gumulka/usb-hub/3D/USB_type_C_smd_12p.stp

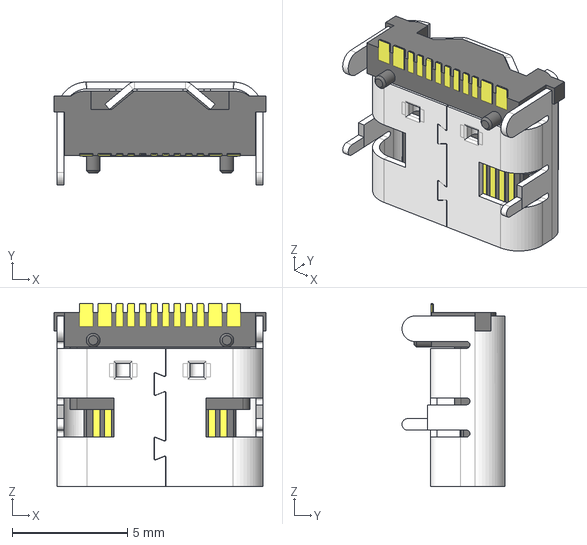
[picture p1: CAD file, 2024-03-02]
3D/USB_type_C_smd_12p.stp
9.20 x 4.47 x 7.95 mm
