gumulka/usb-hub/3D/694106301002 (rev1).stp

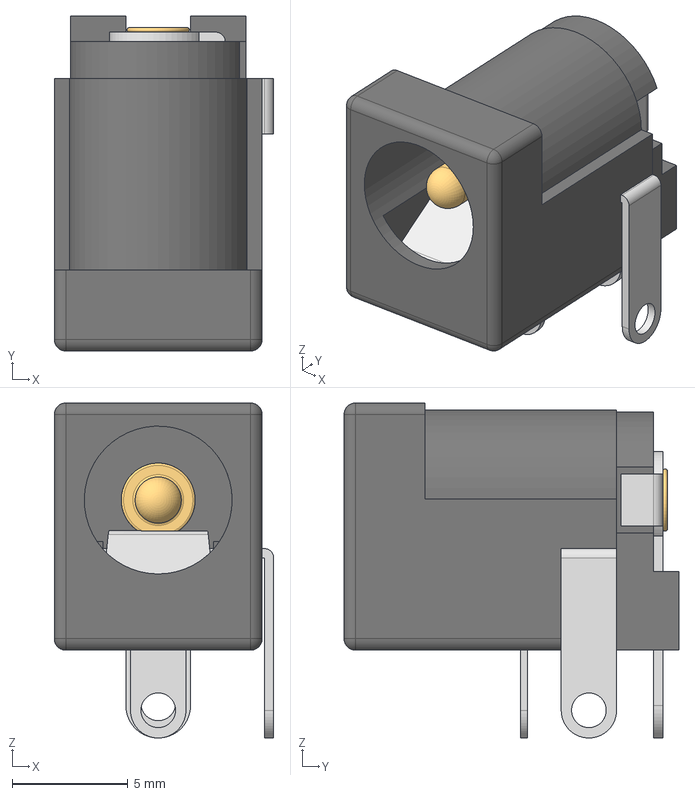
[picture p2: CAD file, 2024-03-02]
3D/694106301002 (rev1).stp
9.50 x 14.5 x 14.5 mm
6941xx301002
694106301002_PinContact
6941xx301002_Back
6941xx301002_PinContact2
6941xx301002_PinLame
6941xx301002_PinBis
