gumulka/usb-hub/usb-hub.kicad_pcb

## KiCad design usb-hub.kicad_pcb (2024-03-20)

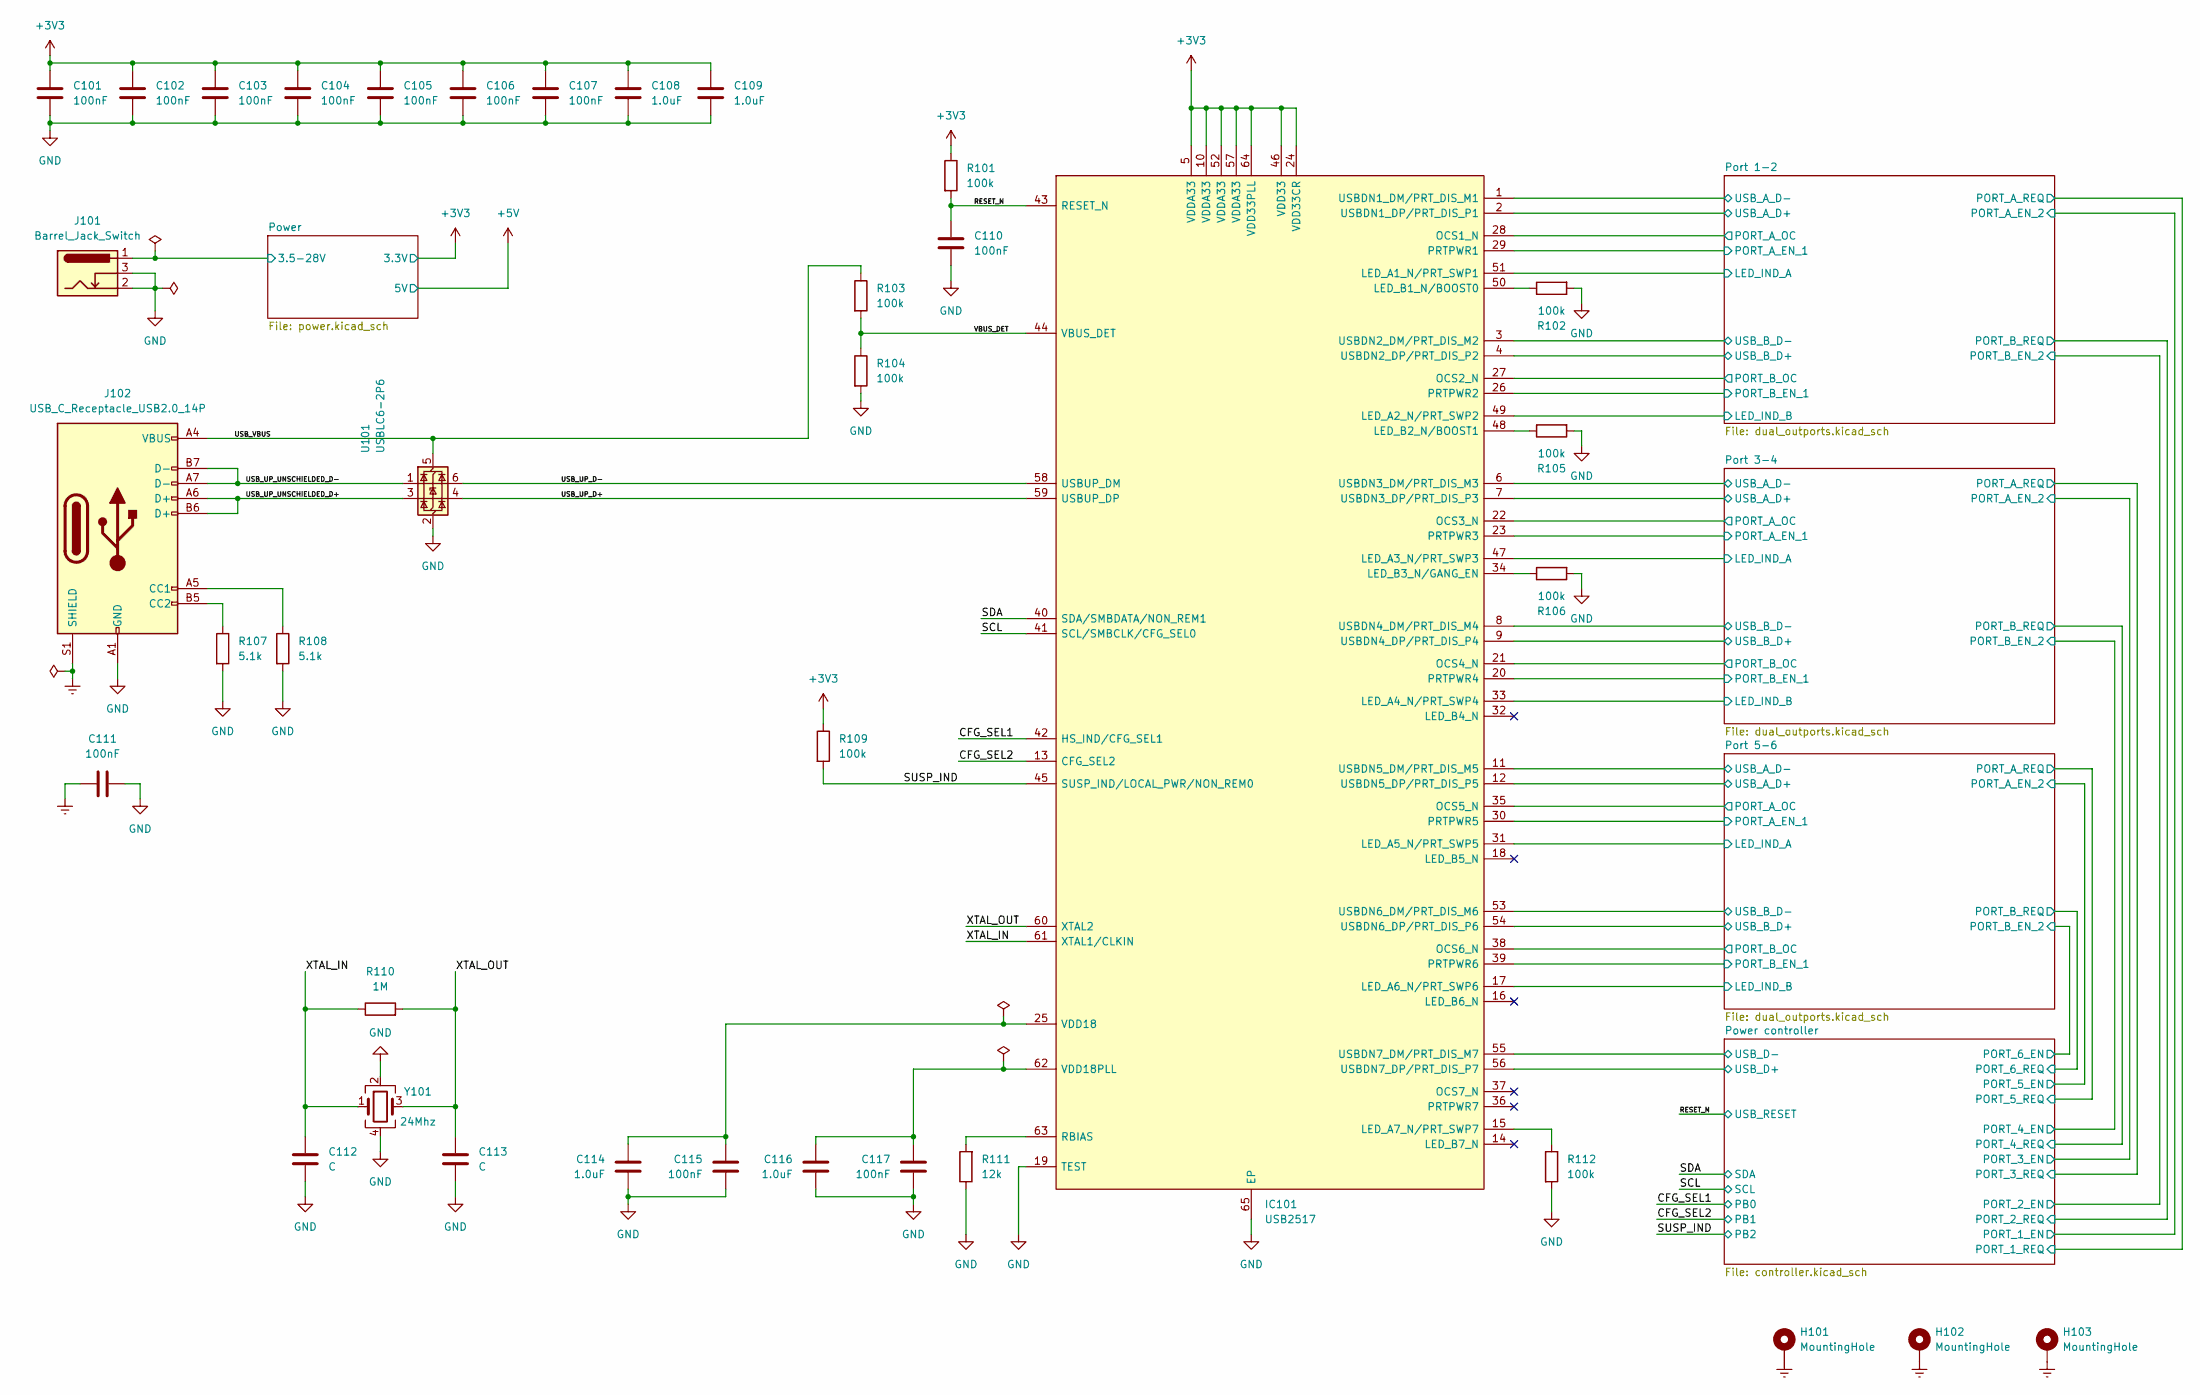
[picture p3: schematic usb-hub.kicad_sch, Switchable USB Hub]

Parts:
C101, C102, C103, C104, C105, C106, C107, C110, C111, C115, C117: 100nF; C_0402_1005Metric; LCSC# C307331
C108, C109, C114, C116: 1.0uF; C_0603_1608Metric; LCSC# C15849
C112, C113: C; C_0402_1005Metric
H101, H102, H103: MountingHole; MountingHole_3.2mm_M3_Pad_Via
IC101: USB2517; QFN-64-1EP_9x9mm_P0.5mm_EP4.7x4.7mm_ThermalVias; MPN USB2517; LCSC# C626668
J101: Barrel_Jack_Switch; BarrelJack_Wuerth_6941xx301002; MPN 694106301002
J102: USB_C_Receptacle_USB2.0_14P; USB_C_Receptacle_G-Switch_GT-USB-7010ASV; LCSC# C2988369
R101, R102, R103, R104, R105, R106, R109, R112: 100k; R_0402_1005Metric; MPN 100K; LCSC# C25741
R107, R108: 5.1k; R_0402_1005Metric; MPN 5,1K; LCSC# C25905
R110: 1M; R_0402_1005Metric; MPN 1M; LCSC# C26083
R111: 12k; R_0402_1005Metric; MPN 12K; LCSC# C25752
U101: USBLC6-2P6; SOT-666; MPN USBLC6-2P6; LCSC# C2827693
Y101: 24Mhz; Crystal_SMD_3225-4Pin_3.2x2.5mm; LCSC# C70590

Connections:
+3V3: C101.1, C102.1, C103.1, C104.1, C105.1, C106.1, C107.1, C108.1, C109.1, IC101.5 (VDDA33), IC101.10 (VDDA33), IC101.24 (VDD33CR), IC101.46 (VDD33), IC101.52 (VDDA33), IC101.57 (VDDA33), IC101.64 (VDD33PLL), R101.1, R109.1; also elsewhere on the board
/CFG_SEL1: IC101.42 (HS_IND/CFG_SEL1); also elsewhere on the board
/CFG_SEL2: IC101.13 (CFG_SEL2); also elsewhere on the board
/Port 1-2/LED_IND_A: IC101.51 (LED_A1_N/PRT_SWP1); also elsewhere on the board
/Port 1-2/LED_IND_B: IC101.49 (LED_A2_N/PRT_SWP2); also elsewhere on the board
/Port 1-2/PORT_A_EN_1: IC101.29 (PRTPWR1); also elsewhere on the board
/Port 1-2/PORT_A_OC: IC101.28 (OCS1_N); also elsewhere on the board
/Port 1-2/PORT_B_EN_1: IC101.26 (PRTPWR2); also elsewhere on the board
/Port 1-2/PORT_B_OC: IC101.27 (OCS2_N); also elsewhere on the board
/Port 1-2/USB_A_D+: IC101.2 (USBDN1_DP/PRT_DIS_P1); also elsewhere on the board
/Port 1-2/USB_A_D-: IC101.1 (USBDN1_DM/PRT_DIS_M1); also elsewhere on the board
/Port 1-2/USB_B_D+: IC101.4 (USBDN2_DP/PRT_DIS_P2); also elsewhere on the board
/Port 1-2/USB_B_D-: IC101.3 (USBDN2_DM/PRT_DIS_M2); also elsewhere on the board
/Port 3-4/LED_IND_A: IC101.47 (LED_A3_N/PRT_SWP3); also elsewhere on the board
/Port 3-4/LED_IND_B: IC101.33 (LED_A4_N/PRT_SWP4); also elsewhere on the board
/Port 3-4/PORT_A_EN_1: IC101.23 (PRTPWR3); also elsewhere on the board
/Port 3-4/PORT_A_OC: IC101.22 (OCS3_N); also elsewhere on the board
/Port 3-4/PORT_B_EN_1: IC101.20 (PRTPWR4); also elsewhere on the board
/Port 3-4/PORT_B_OC: IC101.21 (OCS4_N); also elsewhere on the board
/Port 3-4/USB_A_D+: IC101.7 (USBDN3_DP/PRT_DIS_P3); also elsewhere on the board
/Port 3-4/USB_A_D-: IC101.6 (USBDN3_DM/PRT_DIS_M3); also elsewhere on the board
/Port 3-4/USB_B_D+: IC101.9 (USBDN4_DP/PRT_DIS_P4); also elsewhere on the board
/Port 3-4/USB_B_D-: IC101.8 (USBDN4_DM/PRT_DIS_M4); also elsewhere on the board
/Port 5-6/LED_IND_A: IC101.31 (LED_A5_N/PRT_SWP5); also elsewhere on the board
/Port 5-6/LED_IND_B: IC101.17 (LED_A6_N/PRT_SWP6); also elsewhere on the board
/Port 5-6/PORT_A_EN_1: IC101.30 (PRTPWR5); also elsewhere on the board
/Port 5-6/PORT_A_OC: IC101.35 (OCS5_N); also elsewhere on the board
/Port 5-6/PORT_B_EN_1: IC101.39 (PRTPWR6); also elsewhere on the board
/Port 5-6/PORT_B_OC: IC101.38 (OCS6_N); also elsewhere on the board
/Port 5-6/USB_A_D+: IC101.12 (USBDN5_DP/PRT_DIS_P5); also elsewhere on the board
/Port 5-6/USB_A_D-: IC101.11 (USBDN5_DM/PRT_DIS_M5); also elsewhere on the board
/Port 5-6/USB_B_D+: IC101.54 (USBDN6_DP/PRT_DIS_P6); also elsewhere on the board
/Port 5-6/USB_B_D-: IC101.53 (USBDN6_DM/PRT_DIS_M6); also elsewhere on the board
/Power controller/USB_D+: IC101.56 (USBDN7_DP/PRT_DIS_P7); also elsewhere on the board
/Power controller/USB_D-: IC101.55 (USBDN7_DM/PRT_DIS_M7); also elsewhere on the board
/Power/3.5-28V: J101.1; also elsewhere on the board
/RESET_N: C110.1, IC101.43 (RESET_N), R101.2; also elsewhere on the board
/SCL: IC101.41 (SCL/SMBCLK/CFG_SEL0); also elsewhere on the board
/SDA: IC101.40 (SDA/SMBDATA/NON_REM1); also elsewhere on the board
/SUSP_IND: IC101.45 (SUSP_IND/LOCAL_PWR/NON_REM0), R109.2; also elsewhere on the board
/USB_UP_D+: IC101.59 (USBUP_DP), U101.4 (I/O2)
/USB_UP_D-: IC101.58 (USBUP_DM), U101.6 (I/O1)
/USB_UP_UNSCHIELDED_D+: J102.A6 (D+), J102.B6 (D+), U101.3 (I/O2)
/USB_UP_UNSCHIELDED_D-: J102.A7 (D-), J102.B7 (D-), U101.1 (I/O1)
/USB_VBUS: J102.A4 (VBUS), J102.A9 (VBUS), J102.B4 (VBUS), J102.B9 (VBUS), R103.1, U101.5 (VBUS)
/VBUS_DET: IC101.44 (VBUS_DET), R103.2, R104.1
/XTAL_IN: C112.1, IC101.61 (XTAL1/CLKIN), R110.1, Y101.1
/XTAL_OUT: C113.1, IC101.60 (XTAL2), R110.2, Y101.3
Earth: C111.2, H101.1, H102.1, H103.1, J102.S1 (SHIELD); also elsewhere on the board
GND: C101.2, C102.2, C103.2, C104.2, C105.2, C106.2, C107.2, C108.2, C109.2, C110.2, C111.1, C112.2, C113.2, C114.2, C115.2, C116.2, C117.2, IC101.19 (TEST), IC101.65 (EP), J101.2, J101.3, J102.A1 (GND), J102.A12 (GND), J102.B1 (GND), J102.B12 (GND), R102.2, R104.2, R105.2, R106.2, R107.2, R108.2, R111.1, R112.2, U101.2 (GND), Y101.2, Y101.4; also elsewhere on the board
unnamed: IC101.15 (LED_A7_N/PRT_SWP7), R112.1
unnamed: IC101.50 (LED_B1_N/BOOST0), R102.1
unnamed: IC101.48 (LED_B2_N/BOOST1), R105.1
unnamed: IC101.34 (LED_B3_N/GANG_EN), R106.1
unnamed: IC101.63 (RBIAS), R111.2
unnamed: C114.1, C115.1, IC101.25 (VDD18)
unnamed: C116.1, C117.1, IC101.62 (VDD18PLL)
unnamed: J102.A5 (CC1), R108.1
unnamed: J102.B5 (CC2), R107.1

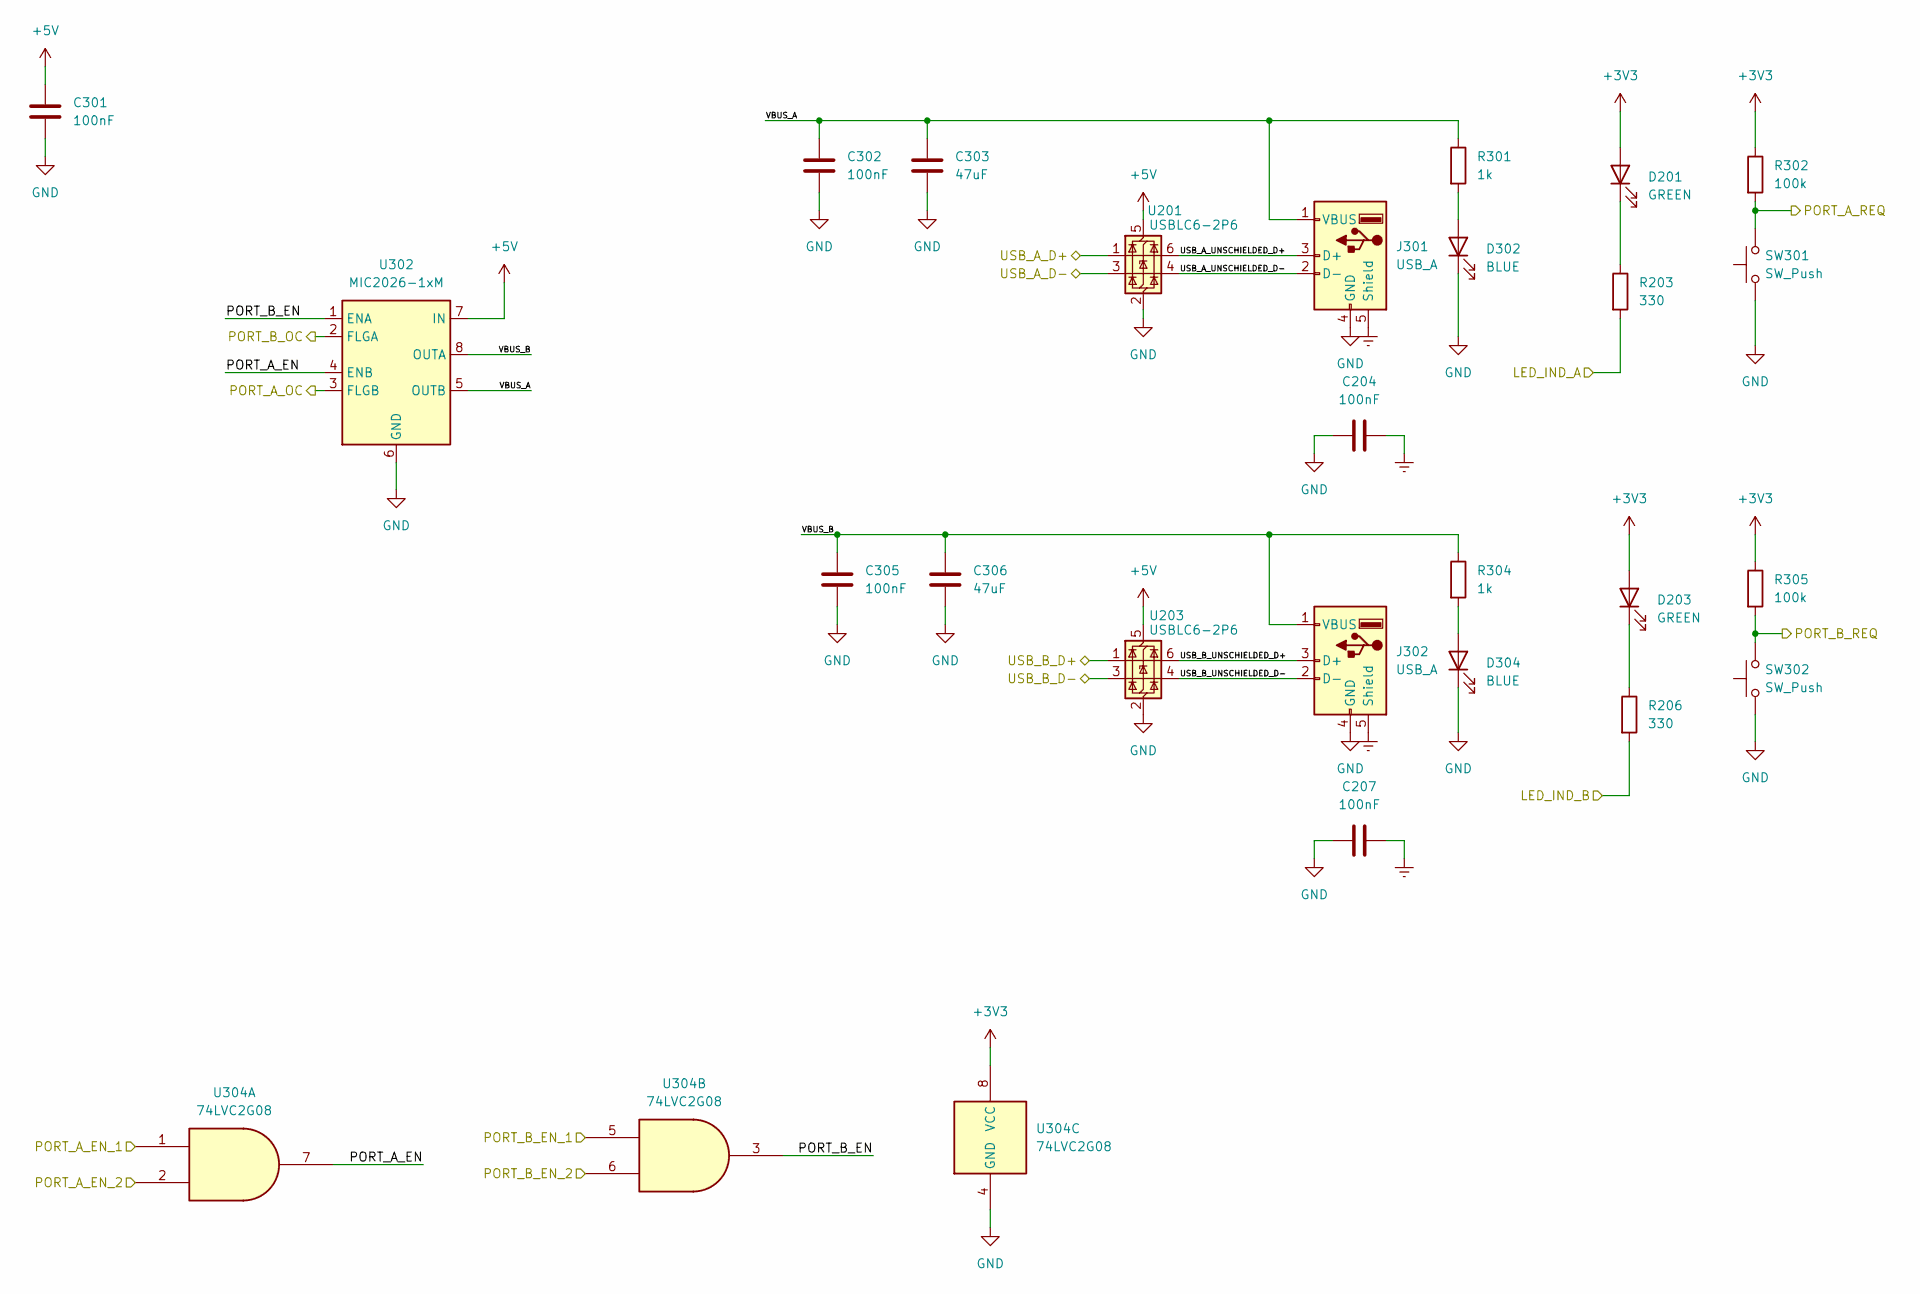
[picture p4: schematic dual_outports.kicad_sch, Switchable USB Hub]

Parts:
C204, C207, C301, C302, C305: 100nF; C_0402_1005Metric; LCSC# C307331
C303, C306: 47uF; C_0805_2012Metric; LCSC# C16780
D201, D203: GREEN; LED_0603_1608Metric; LCSC# C2986059
D302, D304: BLUE; LED_0603_1608Metric; LCSC# C72041
J301, J302: USB_A; UJ2-AV-W4-TH; MPN UJ2-AV-W4-TH
R203, R206: 330; R_0402_1005Metric; MPN 330R; LCSC# C25104
R301, R304: 1k; R_0402_1005Metric; MPN 1k; LCSC# C11702
R302, R305: 100k; R_0402_1005Metric; MPN 100K; LCSC# C25741
SW301, SW302: SW_Push; SW_SPST_TL3342; LCSC# C318884
U201, U203: USBLC6-2P6; SOT-666; MPN USBLC6-2P6; LCSC# C2827693
U302: MIC2026-1xM; SOIC-8_3.9x4.9mm_P1.27mm; MPN MIC2026-1YM; LCSC# C144190
U304: 74LVC2G08; VSSOP-8_2.3x2mm_P0.5mm; MPN 74LVC2G08; LCSC# C91875

Connections:
+3V3: D201.2 (A), D203.2 (A), R302.1, R305.1, U304.8 (VCC); also elsewhere on the board
+5V: C301.1, U201.5 (VBUS), U203.5 (VBUS), U302.7 (IN); also elsewhere on the board
/Port 1-2/LED_IND_A: R203.2; also elsewhere on the board
/Port 1-2/LED_IND_B: R206.2; also elsewhere on the board
/Port 1-2/USB_A_D+: U201.1 (I/O1); also elsewhere on the board
/Port 1-2/USB_A_D-: U201.3 (I/O2); also elsewhere on the board
/Port 1-2/USB_B_D+: U203.1 (I/O1); also elsewhere on the board
/Port 1-2/USB_B_D-: U203.3 (I/O2); also elsewhere on the board
/Port 3-4/PORT_A_EN: U302.4 (ENB), U304.7
/Port 3-4/PORT_A_EN_1: U304.1; also elsewhere on the board
/Port 3-4/PORT_A_EN_2: U304.2; also elsewhere on the board
/Port 3-4/PORT_A_OC: U302.3 (FLGB); also elsewhere on the board
/Port 3-4/PORT_A_REQ: R302.2, SW301.2; also elsewhere on the board
/Port 3-4/PORT_B_EN: U302.1 (ENA), U304.3
/Port 3-4/PORT_B_EN_1: U304.5; also elsewhere on the board
/Port 3-4/PORT_B_EN_2: U304.6; also elsewhere on the board
/Port 3-4/PORT_B_OC: U302.2 (FLGA); also elsewhere on the board
/Port 3-4/PORT_B_REQ: R305.2, SW302.2; also elsewhere on the board
/Port 3-4/VBUS_A: C302.1, C303.1, J301.1 (VBUS), R301.1, U302.5 (OUTB)
/Port 3-4/VBUS_B: C305.1, C306.1, J302.1 (VBUS), R304.1, U302.8 (OUTA)
Earth: C204.2, C207.2, J301.5 (Shield), J302.5 (Shield); also elsewhere on the board
GND: C204.1, C207.1, C301.2, C302.2, C303.2, C305.2, C306.2, D302.1 (K), D304.1 (K), J301.4 (GND), J302.4 (GND), SW301.1, SW302.1, U201.2 (GND), U203.2 (GND), U302.6 (GND), U304.4 (GND); also elsewhere on the board
unnamed: D201.1 (K), R203.1
unnamed: D203.1 (K), R206.1
unnamed: D302.2 (A), R301.2
unnamed: D304.2 (A), R304.2

Parts of its further copies:
C201, C202, C205, C304, C307, C401, C402, C404, C405, C407: 100nF; C_0402_1005Metric; LCSC# C307331
C203, C206, C403, C406: 47uF; C_0805_2012Metric; LCSC# C16780
D202, D204, D402, D404: BLUE; LED_0603_1608Metric; LCSC# C72041
D301, D303, D401, D403: GREEN; LED_0603_1608Metric; LCSC# C2986059
J201, J202, J401, J402: USB_A; UJ2-AV-W4-TH; MPN UJ2-AV-W4-TH
R201, R204, R401, R404: 1k; R_0402_1005Metric; MPN 1k; LCSC# C11702
R202, R205, R402, R405: 100k; R_0402_1005Metric; MPN 100K; LCSC# C25741
R303, R306, R403, R406: 330; R_0402_1005Metric; MPN 330R; LCSC# C25104
SW201, SW202, SW401, SW402: SW_Push; SW_SPST_TL3342; LCSC# C318884
U202, U402: MIC2026-1xM; SOIC-8_3.9x4.9mm_P1.27mm; MPN MIC2026-1YM; LCSC# C144190
U204, U404: 74LVC2G08; VSSOP-8_2.3x2mm_P0.5mm; MPN 74LVC2G08; LCSC# C91875
U301, U303, U401, U403: USBLC6-2P6; SOT-666; MPN USBLC6-2P6; LCSC# C2827693

Connections of its further copies:
+3V3: D301.2 (A), D303.2 (A), D401.2 (A), D403.2 (A), R202.1, R205.1, R402.1, R405.1, U204.8 (VCC), U404.8 (VCC); also elsewhere on the board
+5V: C201.1, C401.1, U202.7 (IN), U301.5 (VBUS), U303.5 (VBUS), U401.5 (VBUS), U402.7 (IN), U403.5 (VBUS); also elsewhere on the board
/Port 1-2/PORT_A_EN: U202.4 (ENB), U204.7
/Port 1-2/PORT_A_EN_1: U204.1; also elsewhere on the board
/Port 1-2/PORT_A_EN_2: U204.2; also elsewhere on the board
/Port 1-2/PORT_A_OC: U202.3 (FLGB); also elsewhere on the board
/Port 1-2/PORT_A_REQ: R202.2, SW201.2; also elsewhere on the board
/Port 1-2/PORT_B_EN: U202.1 (ENA), U204.3
/Port 1-2/PORT_B_EN_1: U204.5; also elsewhere on the board
/Port 1-2/PORT_B_EN_2: U204.6; also elsewhere on the board
/Port 1-2/PORT_B_OC: U202.2 (FLGA); also elsewhere on the board
/Port 1-2/PORT_B_REQ: R205.2, SW202.2; also elsewhere on the board
/Port 1-2/VBUS_A: C202.1, C203.1, J201.1 (VBUS), R201.1, U202.5 (OUTB)
/Port 1-2/VBUS_B: C205.1, C206.1, J202.1 (VBUS), R204.1, U202.8 (OUTA)
/Port 3-4/LED_IND_A: R303.2; also elsewhere on the board
/Port 3-4/LED_IND_B: R306.2; also elsewhere on the board
/Port 3-4/USB_A_D+: U301.1 (I/O1); also elsewhere on the board
/Port 3-4/USB_A_D-: U301.3 (I/O2); also elsewhere on the board
/Port 3-4/USB_B_D+: U303.1 (I/O1); also elsewhere on the board
/Port 3-4/USB_B_D-: U303.3 (I/O2); also elsewhere on the board
/Port 5-6/LED_IND_A: R403.2; also elsewhere on the board
/Port 5-6/LED_IND_B: R406.2; also elsewhere on the board
/Port 5-6/PORT_A_EN: U402.4 (ENB), U404.7
/Port 5-6/PORT_A_EN_1: U404.1; also elsewhere on the board
/Port 5-6/PORT_A_EN_2: U404.2; also elsewhere on the board
/Port 5-6/PORT_A_OC: U402.3 (FLGB); also elsewhere on the board
/Port 5-6/PORT_A_REQ: R402.2, SW401.2; also elsewhere on the board
/Port 5-6/PORT_B_EN: U402.1 (ENA), U404.3
/Port 5-6/PORT_B_EN_1: U404.5; also elsewhere on the board
/Port 5-6/PORT_B_EN_2: U404.6; also elsewhere on the board
/Port 5-6/PORT_B_OC: U402.2 (FLGA); also elsewhere on the board
/Port 5-6/PORT_B_REQ: R405.2, SW402.2; also elsewhere on the board
/Port 5-6/USB_A_D+: U401.1 (I/O1); also elsewhere on the board
/Port 5-6/USB_A_D-: U401.3 (I/O2); also elsewhere on the board
/Port 5-6/USB_A_UNSCHIELDED_D+: J401.3 (D+), U401.6 (I/O1)
/Port 5-6/USB_A_UNSCHIELDED_D-: J401.2 (D-), U401.4 (I/O2)
/Port 5-6/USB_B_D+: U403.1 (I/O1); also elsewhere on the board
/Port 5-6/USB_B_D-: U403.3 (I/O2); also elsewhere on the board
/Port 5-6/USB_B_UNSCHIELDED_D+: J402.3 (D+), U403.6 (I/O1)
/Port 5-6/USB_B_UNSCHIELDED_D-: J402.2 (D-), U403.4 (I/O2)
/Port 5-6/VBUS_A: C402.1, C403.1, J401.1 (VBUS), R401.1, U402.5 (OUTB)
/Port 5-6/VBUS_B: C405.1, C406.1, J402.1 (VBUS), R404.1, U402.8 (OUTA)
Earth: C304.2, C307.2, C404.2, C407.2, J201.5 (Shield), J202.5 (Shield), J401.5 (Shield), J402.5 (Shield); also elsewhere on the board
GND: C201.2, C202.2, C203.2, C205.2, C206.2, C304.1, C307.1, C401.2, C402.2, C403.2, C404.1, C405.2, C406.2, C407.1, D202.1 (K), D204.1 (K), D402.1 (K), D404.1 (K), J201.4 (GND), J202.4 (GND), J401.4 (GND), J402.4 (GND), SW201.1, SW202.1, SW401.1, SW402.1, U202.6 (GND), U204.4 (GND), U301.2 (GND), U303.2 (GND), U401.2 (GND), U402.6 (GND), U403.2 (GND), U404.4 (GND); also elsewhere on the board
unnamed: D202.2 (A), R201.2
unnamed: D204.2 (A), R204.2
unnamed: D301.1 (K), R303.1
unnamed: D303.1 (K), R306.1
unnamed: D401.1 (K), R403.1
unnamed: D402.2 (A), R401.2
unnamed: D403.1 (K), R406.1
unnamed: D404.2 (A), R404.2

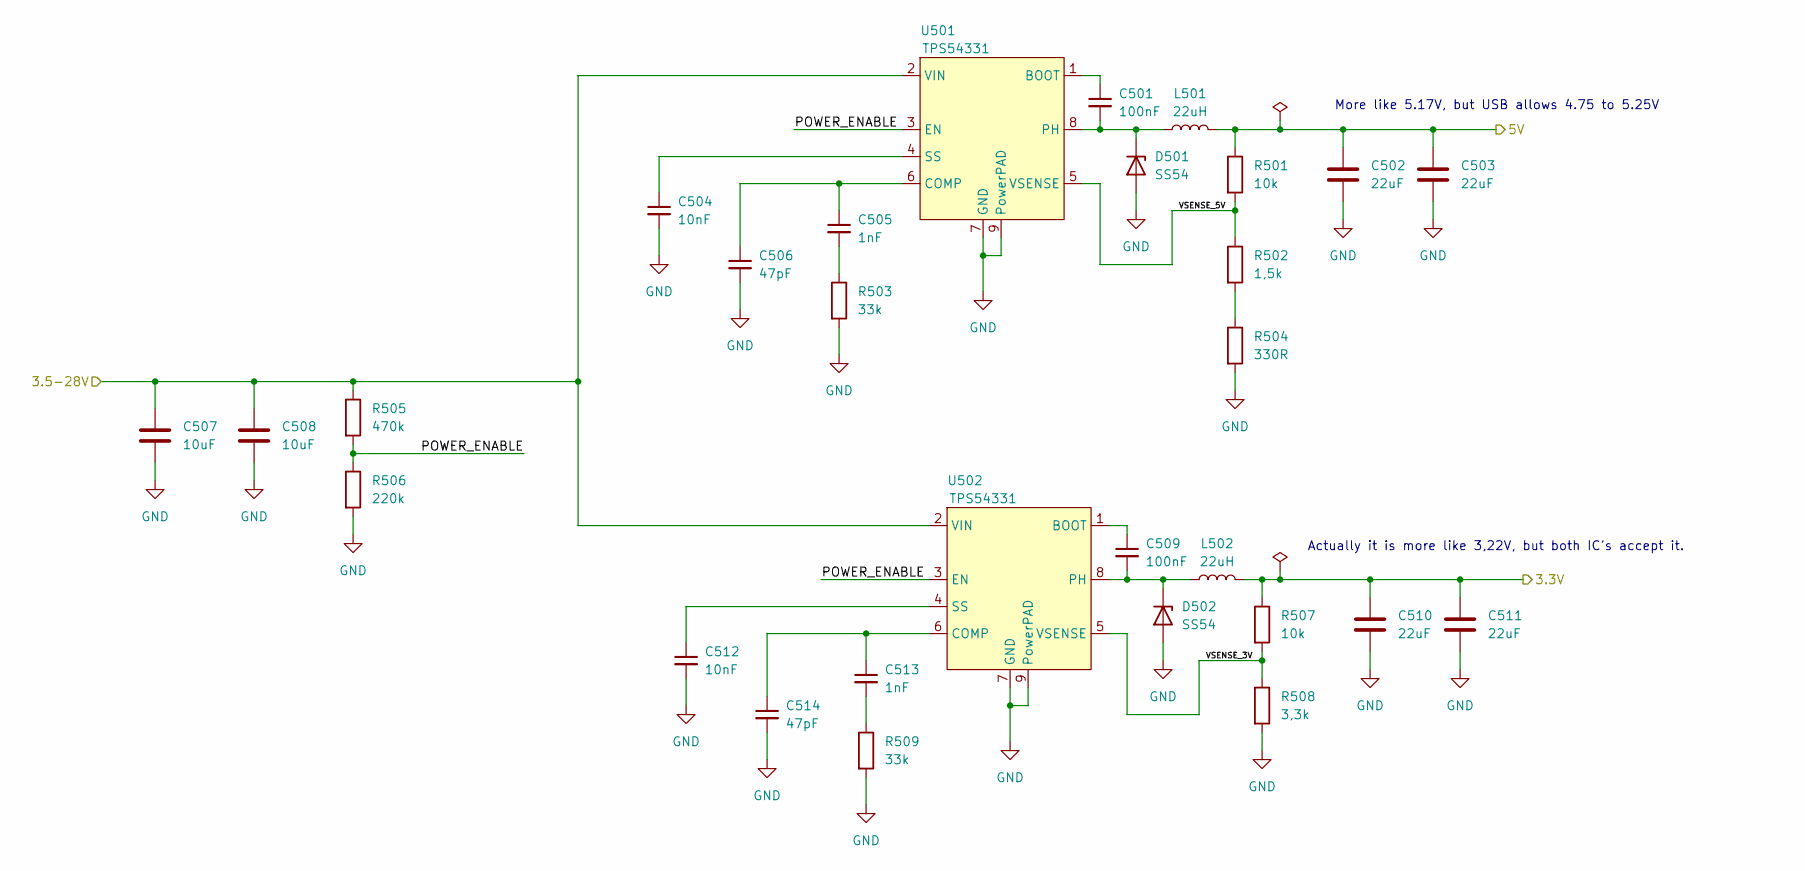
[picture p5: schematic power.kicad_sch, Switchable USB Hub]

Parts:
C501, C509: 100nF; C_0402_1005Metric; LCSC# C307331
C502, C503, C510, C511: 22uF; C_0603_1608Metric; MPN 6.3V 22uF; LCSC# C59461
C504, C512: 10nF; C_0402_1005Metric; LCSC# C15195
C505, C513: 1nF; C_0402_1005Metric; LCSC# C1523
C506, C514: 47pF; C_0402_1005Metric; LCSC# C1567
C507, C508: 10uF; C_0805_2012Metric; MPN 50V 10uF; LCSC# C440198
D501, D502: SS54; D_SMA; LCSC# C22452
L501, L502: 22uH; YSPI0630A; MPN 3A 22uH; LCSC# C497873
R501, R507: 10k; R_0402_1005Metric; MPN 10k; LCSC# C25744
R502: 1,5k; R_0402_1005Metric; MPN 1,5k; LCSC# C25867
R503, R509: 33k; R_0402_1005Metric; MPN 33k; LCSC# C25779
R504: 330R; R_0402_1005Metric; MPN 330R; LCSC# C25104
R505: 470k; R_0402_1005Metric; MPN 470k; LCSC# C25790
R506: 220k; R_0402_1005Metric; MPN 220k; LCSC# C25767
R508: 3,3k; R_0402_1005Metric; MPN 3,3k; LCSC# C25890
U501, U502: TPS54331; SOIC-8-1EP_3.9x4.9mm_P1.27mm_EP2.29x3mm_ThermalVias; MPN TPS54331; LCSC# C9865

Connections:
+3V3: C510.1, C511.1, L502.2, R507.1; also elsewhere on the board
+5V: C502.1, C503.1, L501.2, R501.1; also elsewhere on the board
/Power/3.5-28V: C507.1, C508.1, R505.1, U501.2 (VIN), U502.2 (VIN); also elsewhere on the board
/Power/POWER_ENABLE: R505.2, R506.1, U501.3 (EN), U502.3 (EN)
/Power/VSENSE_3V: R507.2, R508.1, U502.5 (VSENSE)
/Power/VSENSE_5V: R501.2, R502.1, U501.5 (VSENSE)
GND: C502.2, C503.2, C504.2, C506.2, C507.2, C508.2, C510.2, C511.2, C512.2, C514.2, D501.2 (A), D502.2 (A), R503.2, R504.2, R506.2, R508.2, R509.2, U501.7 (GND), U501.9 (PowerPAD), U502.7 (GND), U502.9 (PowerPAD); also elsewhere on the board
unnamed: C505.2, R503.1
unnamed: C513.2, R509.1
unnamed: C501.2, D501.1 (K), L501.1, U501.8 (PH)
unnamed: C509.2, D502.1 (K), L502.1, U502.8 (PH)
unnamed: R502.2, R504.1
unnamed: C501.1, U501.1 (BOOT)
unnamed: C505.1, C506.1, U501.6 (COMP)
unnamed: C504.1, U501.4 (SS)
unnamed: C509.1, U502.1 (BOOT)
unnamed: C513.1, C514.1, U502.6 (COMP)
unnamed: C512.1, U502.4 (SS)

Notes on the sheet:
Actually it is more like 3,22V, but both IC's accept it.
More like 5.17V, but USB allows 4.75 to 5.25V

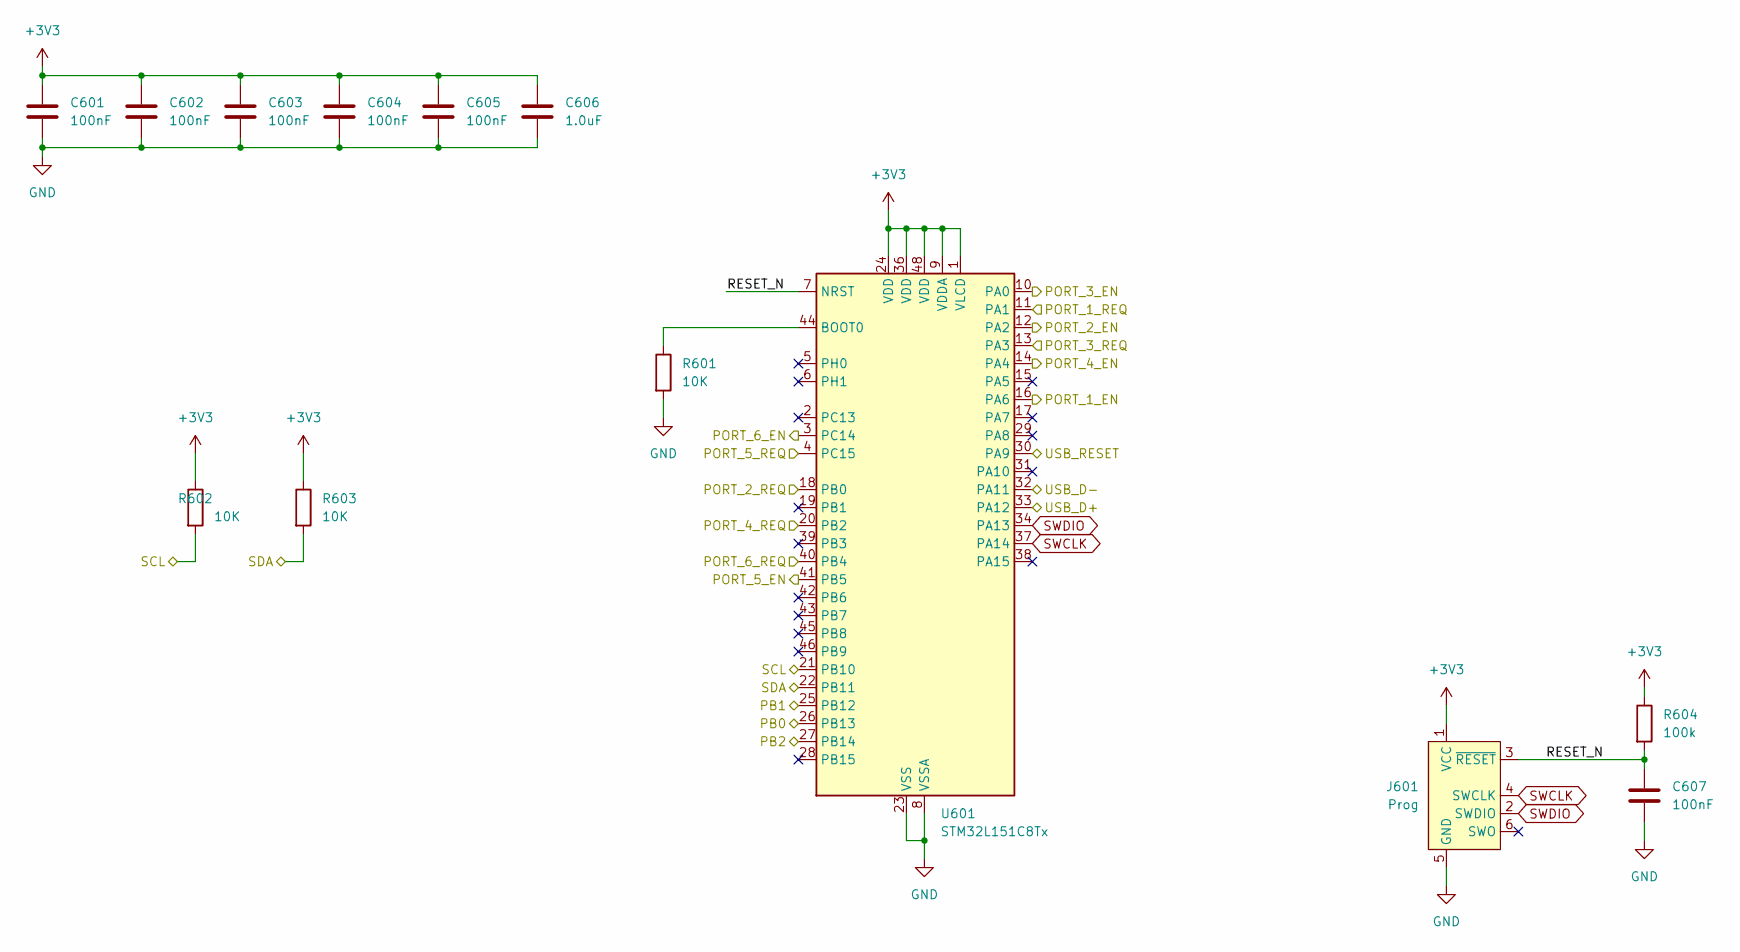
[picture p6: schematic controller.kicad_sch, Switchable USB Hub]

Parts:
C601, C602, C603, C604, C605, C607: 100nF; C_0402_1005Metric; LCSC# C307331
C606: 1.0uF; C_0603_1608Metric; LCSC# C15849
J601: Prog; Tag-Connect_TC2030-IDC-NL_2x03_P1.27mm_Vertical
R601, R602, R603: 10K; R_0402_1005Metric; MPN 10k; LCSC# C25744
R604: 100k; R_0402_1005Metric; MPN 100K; LCSC# C25741
U601: STM32L151C8Tx; LQFP-48_7x7mm_P0.5mm; MPN STM32L151C8T6; LCSC# C9861

Connections:
+3V3: C601.1, C602.1, C603.1, C604.1, C605.1, C606.1, J601.1 (VCC), R602.1, R603.1, R604.1, U601.1 (VLCD), U601.9 (VDDA), U601.24 (VDD), U601.36 (VDD), U601.48 (VDD); also elsewhere on the board
/CFG_SEL1: U601.26 (PB13); also elsewhere on the board
/CFG_SEL2: U601.25 (PB12); also elsewhere on the board
/Port 1-2/PORT_A_EN_2: U601.16 (PA6); also elsewhere on the board
/Port 1-2/PORT_A_REQ: U601.11 (PA1); also elsewhere on the board
/Port 1-2/PORT_B_EN_2: U601.12 (PA2); also elsewhere on the board
/Port 1-2/PORT_B_REQ: U601.18 (PB0); also elsewhere on the board
/Port 3-4/PORT_A_EN_2: U601.10 (PA0); also elsewhere on the board
/Port 3-4/PORT_A_REQ: U601.13 (PA3); also elsewhere on the board
/Port 3-4/PORT_B_EN_2: U601.14 (PA4); also elsewhere on the board
/Port 3-4/PORT_B_REQ: U601.20 (PB2); also elsewhere on the board
/Port 5-6/PORT_A_EN_2: U601.41 (PB5); also elsewhere on the board
/Port 5-6/PORT_A_REQ: U601.4 (PC15); also elsewhere on the board
/Port 5-6/PORT_B_EN_2: U601.3 (PC14); also elsewhere on the board
/Port 5-6/PORT_B_REQ: U601.40 (PB4); also elsewhere on the board
/Power controller/RESET_N: C607.1, J601.3 (~RESET), R604.2, U601.7 (NRST)
/Power controller/USB_D+: U601.33 (PA12); also elsewhere on the board
/Power controller/USB_D-: U601.32 (PA11); also elsewhere on the board
/RESET_N: U601.30 (PA9); also elsewhere on the board
/SCL: R602.2, U601.21 (PB10); also elsewhere on the board
/SDA: R603.2, U601.22 (PB11); also elsewhere on the board
/SUSP_IND: U601.27 (PB14); also elsewhere on the board
GND: C601.2, C602.2, C603.2, C604.2, C605.2, C606.2, C607.2, J601.5 (GND), R601.2, U601.8 (VSSA), U601.23 (VSS), U601.35 (VSS), U601.47 (VSS); also elsewhere on the board
unnamed: R601.1, U601.44 (BOOT0)
SWCLK: J601.4 (SWCLK), U601.37 (PA14)
SWDIO: J601.2 (SWDIO), U601.34 (PA13)

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
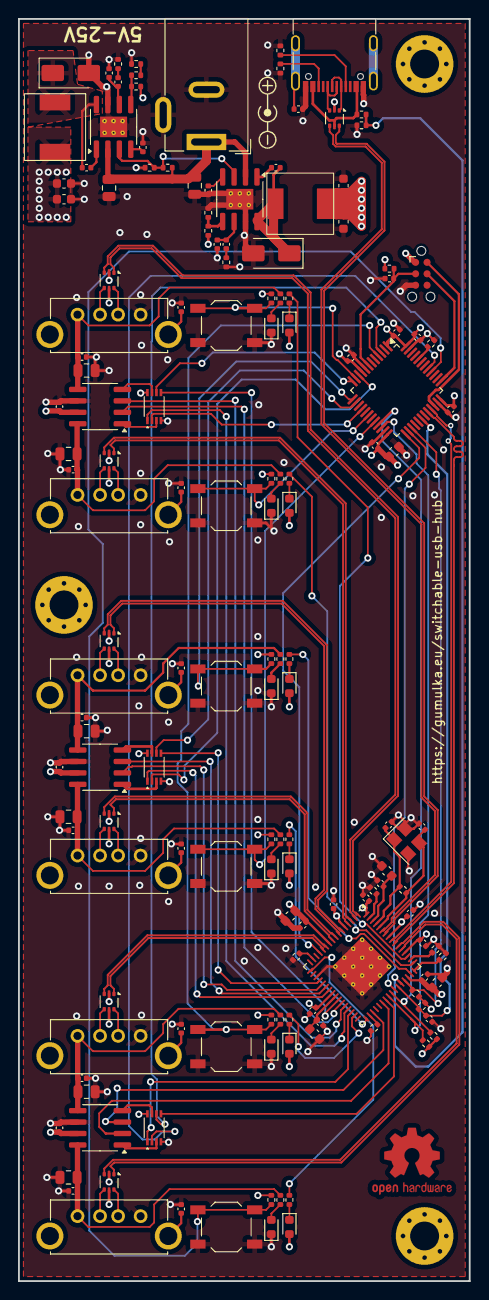
[picture p7: board usb-hub.kicad_pcb from above]

Board: 4 copper layers, 50.0 x 140.0 mm, 154 parts (0 on the bottom side), 126 nets.
