gumulka/usb-hub/(commit log)

2024-02-28 Initial Idea with 12 ports
    [controller.kicad_sch, downstream.kicad_sch, dual_outports.kicad_sch, power.kicad_sch, root_hub.kicad_sch, usb-hub.kicad_pcb, usb-hub.kicad_sch]
2024-03-02 Add power management
    And also some random stuff here and there
    [controller.kicad_sch, dual_outports.kicad_sch, power.kicad_sch, root_hub.kicad_sch, usb-hub.kicad_pcb, usb-hub.kicad_sch]
2024-03-02 Refine connectors and overall shape
    Replace USB connectors, because of availability.
    Use available barrel jack and USB-C connector instead of generic ones.
    Update 3D Models
    Refine rough placement of parts and board outline
    [694106301002 (rev1).stp, USB_type_C_smd_12p.stp, controller.kicad_sch, dual_outports.kicad_sch, power.kicad_sch, usb-hub.kicad_pcb, usb-hub.kicad_sch]
2024-03-16 Add preliminary routing
    Add routing for power paths - 3.3V, 5V and Input power
    Add routing close to USB-Ports
    Mising routing for main IC's and differntial pair routing
    [dual_outports.kicad_sch, usb-hub.kicad_pcb, usb-hub.kicad_sch]
2024-03-17 Finish first routing
    Routed everything, so that the DRC and ERC do not show anything.
    [controller.kicad_sch, dual_outports.kicad_sch, power.kicad_sch, usb-hub.kicad_pcb, usb-hub.kicad_sch]
2024-03-18 Improve routing
    [usb-hub.kicad_pcb]
2024-03-20 Update to new enviroment
    Kicad 8 & global symbols and footprint library
    [controller.kicad_sch, dual_outports.kicad_sch, power.kicad_sch, usb-hub.kicad_pcb, usb-hub.kicad_sch]
2024-04-12 Add case for USB Hub
    Designed a preliminary case with FreeCAD
